6901012610544-SUTTIPAT/Communication-Experiment-2/OUTPUT/2026-11-04/RX_000006/payload_lamduan_bd2.jpg

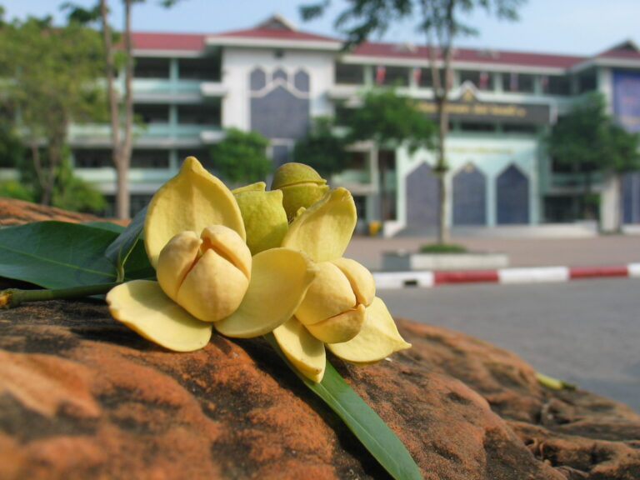
OUTPUT/2026-11-04/RX_000006/payload_lamduan_bd2.jpg
